DarkZachi83/NIUCHACZ-POST-Code-Sniffer-/docs/img/app.png

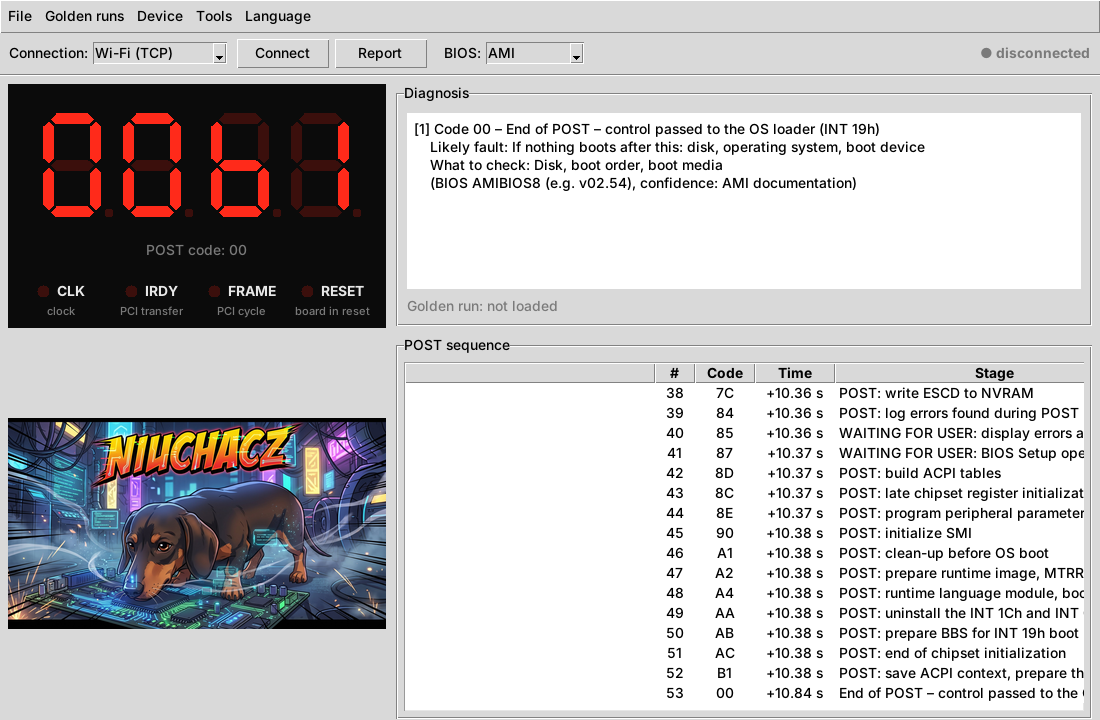
docs/img/app.png
