DarkZachi83/NIUCHACZ-POST-Code-Sniffer-/enclosure/niuchacz_box_podglad.png

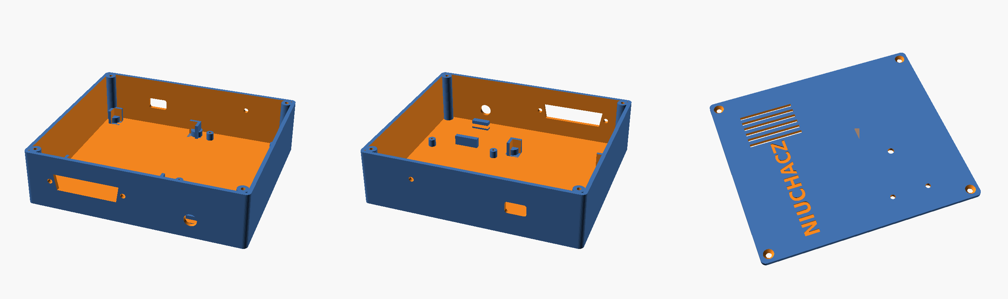
enclosure/niuchacz_box_podglad.png
