DarkZachi83/NIUCHACZ-POST-Code-Sniffer-/enclosure/niuchacz_box_v2_podglad.png

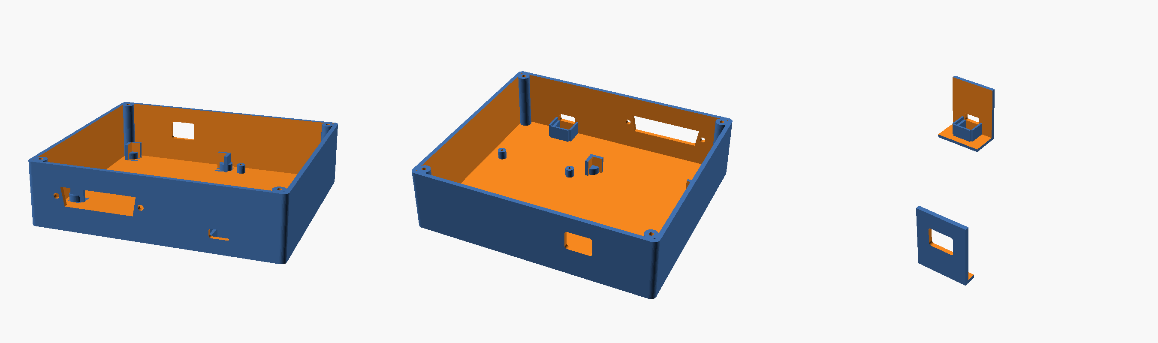
enclosure/niuchacz_box_v2_podglad.png
