DarkZachi83/NIUCHACZ-POST-Code-Sniffer-/enclosure/niuchacz_box_base.stl

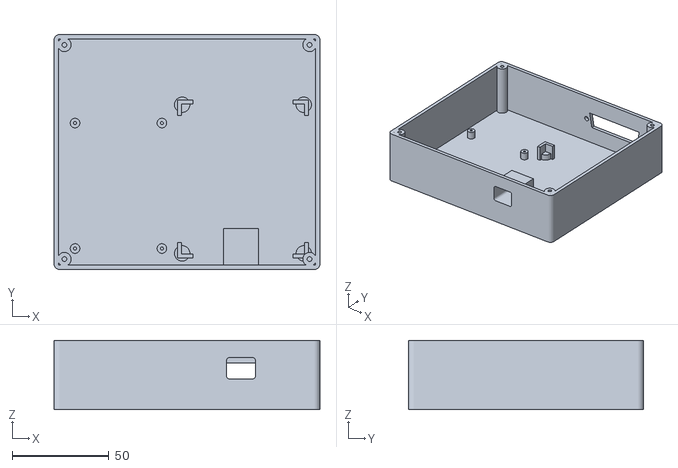
[picture p13: CAD file, 2026-10-23]
enclosure/niuchacz_box_base.stl
137.8 x 121.8 x 36.0
