DarkZachi83/NIUCHACZ-POST-Code-Sniffer-/enclosure/niuchacz_box_test.stl

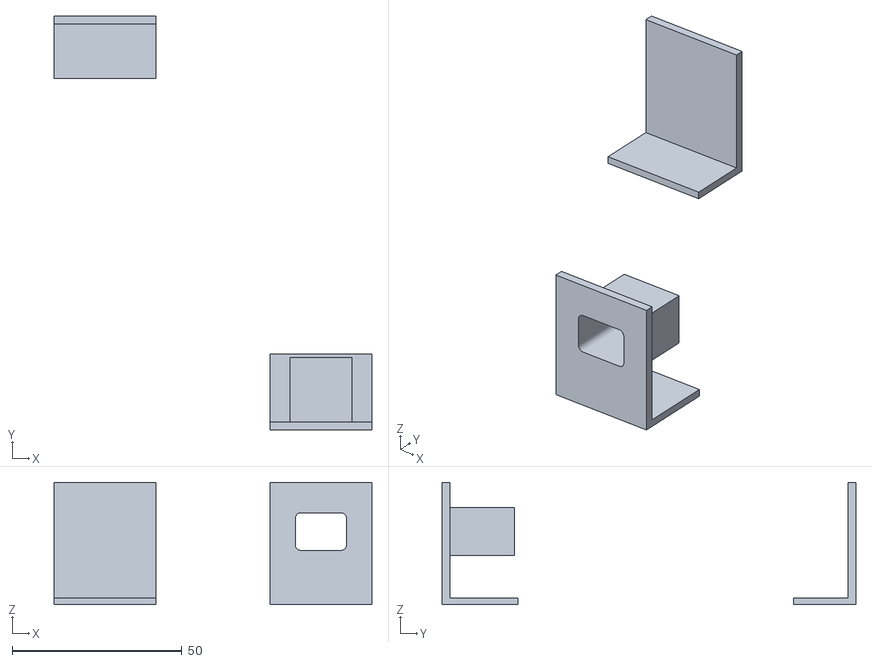
[picture p14: CAD file, 2026-10-23]
enclosure/niuchacz_box_test.stl
93.5 x 121.8 x 36.0
