DarkZachi83/NIUCHACZ-POST-Code-Sniffer-/enclosure/niuchacz_box_lid.stl

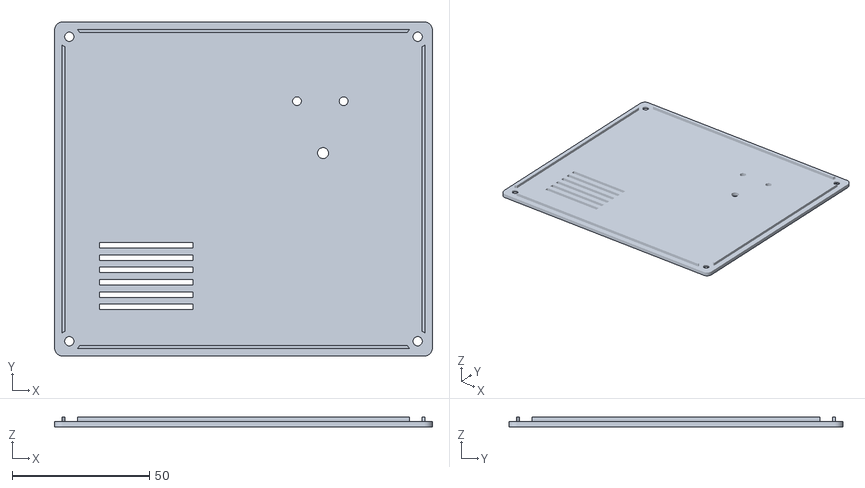
[picture p15: CAD file, 2026-10-23]
enclosure/niuchacz_box_lid.stl
137.8 x 121.8 x 3.60
