DarkZachi83/NIUCHACZ-POST-Code-Sniffer-/(list of files, cad)

Other CAD files:
enclosure/niuchacz_box_v1.scad
