DarkZachi83/NIUCHACZ-POST-Code-Sniffer-/docs/img/box_wiring.png

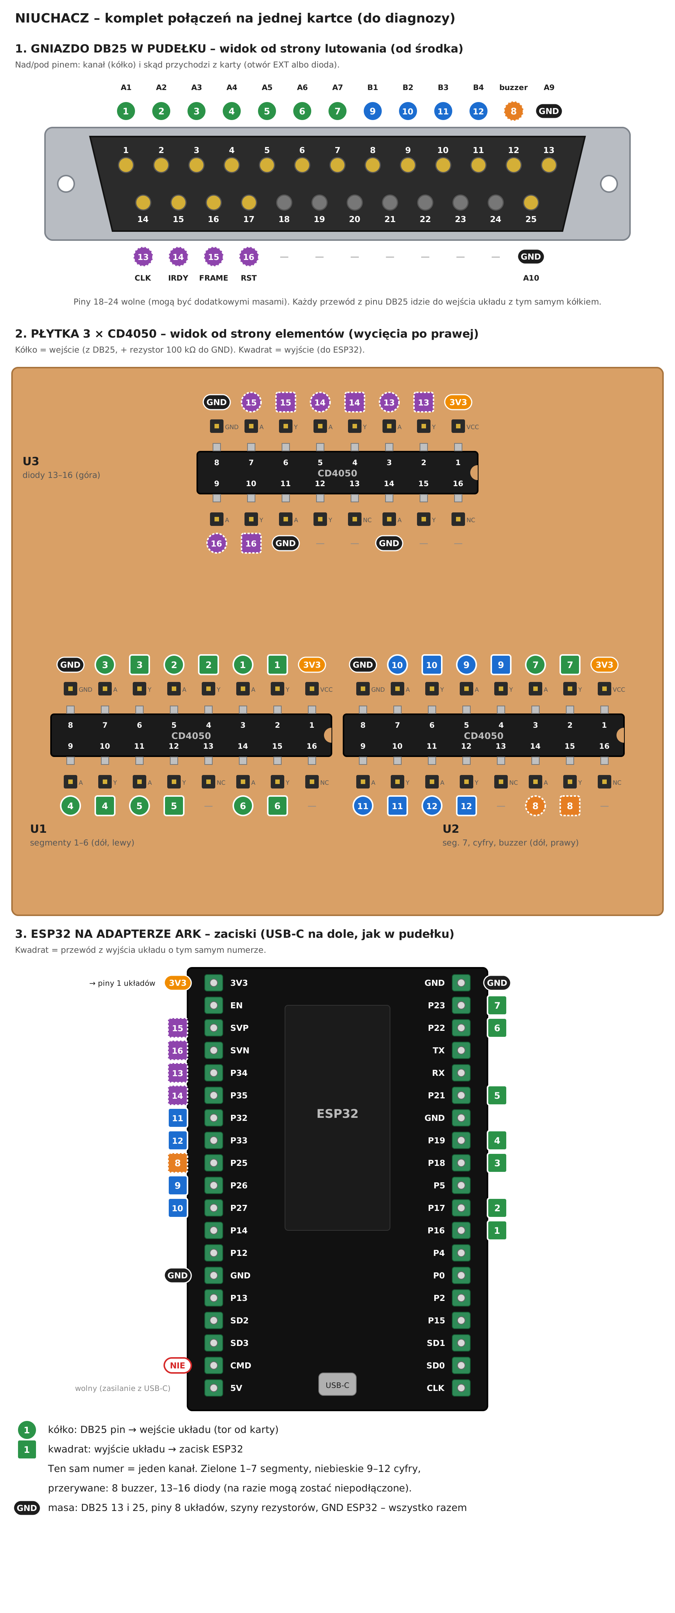
docs/img/box_wiring.png
