DarkZachi83/NIUCHACZ-POST-Code-Sniffer-/docs/img/card_374_wiring.png

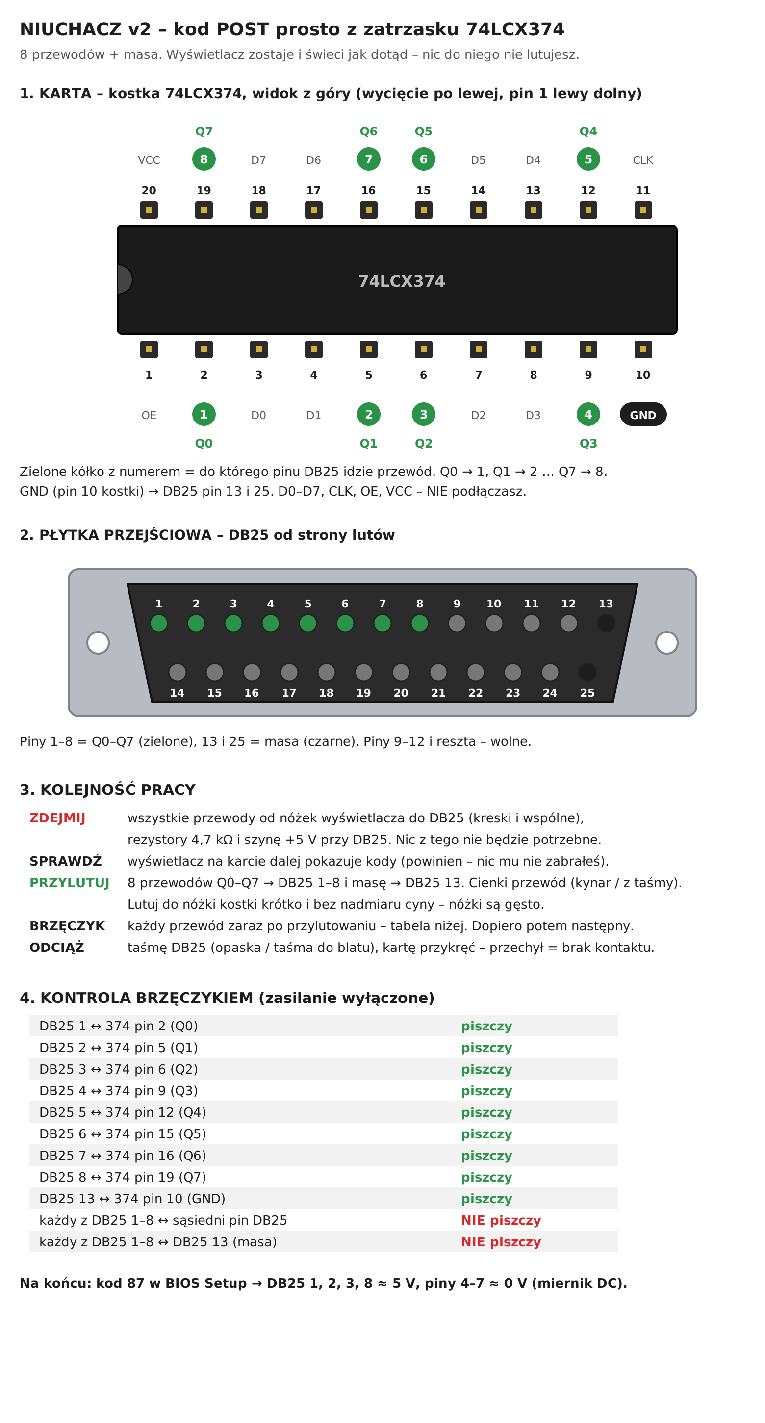
docs/img/card_374_wiring.png
