DarkZachi83/NIUCHACZ-POST-Code-Sniffer-/(commit log)

2026-10-23 NIUCHACZ 0.1 – pierwsza publiczna wersja / first public version
    Rejestrator kodów POST: ESP32 czyta zatrzask 74LCX374 karty POST PCI/ISA
    (Q0–Q7), aplikacja na PC zapisuje przebieg, opisuje kody AMIBIOS8 i tworzy raporty.
    POST code logger: an ESP32 reads the 74LCX374 latch of a PCI/ISA POST card,
    the desktop app records the run, describes AMIBIOS8 codes and builds reports.
    Claude-Session: https://claude.ai/code/session_01U3ZjCWiAyo7WSGjvTnHQTT
    [niuchacz_box.scad, niuchacz_box_base.stl, niuchacz_box_lid.stl, niuchacz_box_test.stl, niuchacz_box_v1.scad]
2026-10-23 README: odczyt z pinów układu 74LCX374 zamiast „zatrzasku” / reading the 74LCX374 pins
    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
2026-10-25 Narzędzie led_probe.py – szukanie sygnałów diod karty / tool for locating card LED signals
    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
2026-10-26 led_probe: pomiar ciągły bez przerw / continuous measurement
    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
2026-10-26 Firmware: diody karty w trybie zatrzasku, sesje z linii RESET / card LEDs and RESET-based sessions
    Pomiar 26.10.2026: IRDY i FRAME widoczne przy ruchu na szynie PCI, RESET = 0 w resecie,
    CLK 33 MHz za szybki dla toru CD4050 (zostaje bez odczytu).
    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
    [config.py, latch_probe.py, main.py, sampler.py]
2026-10-26 USB: bez błędu przy rozłączaniu (wątek najpierw kończy odczyt) / fix serial race on disconnect
    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
    [serial_transport.py]
2026-10-26 REC: record runs on demand, no automatic report popups
    - Live view always runs; nothing is saved or popped up by itself.
    - REC (F9) arms recording; it starts on RESET release (or boot-block code,
    or the first code when armed before power-on).
    - A reset during recording opens the next start in the same recording;
    after max starts (default 4) it ends with "restart loop" and the last
    code before each reset.
    - Ends on POST done (00/FF + 3 s), BIOS waiting (85/87, 5 s), stall or STOP.
    - Auto-saves TXT report + CSV to reports/, then asks "Record the next run?".
    - "Save last run" for runs that were not armed.
    - Report window only on request (Report / Ctrl+R) or if enabled in Settings.
    - EN/PL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
    [config.py, main.py]
2026-10-26 AMI: only D0 (reset vector) starts a new boot
    A real ASRock 775V88 recording showed DE right after code 90 (20 ms, no
    reset): the board runs D3 -> memory codes 10..90 -> DE, D4, D5... inside
    one boot. Treating any D* as a restart split one healthy boot into an
    extra "start" (and in older versions popped up an extra report).
    Other D* codes still count as a restart after a wait code or a stall,
    for the slow 7-segment mode where D0 can be missed.
    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
2026-10-26 Firmware: shorter blind gaps between latch windows, measure and flag them
    Three recordings of the same healthy ASRock 775V88 showed different code
    sets (e.g. 7C..AC missing but B1 present) - the latch keeps only the last
    byte, so codes written while the ESP32 is not sampling are lost.
    Firmware:
    - USB output is queued and sent ~1 line per gap (UART blocks ~3 ms/line,
    even with no PC attached); the rest is sent when the board is idle.
    - Flash flush and gc only when no new code for 1 s (were every 10 lines
    and every heartbeat, mid-burst).
    - LED state sent only on change (+2 s keepalive), not stored on flash.
    - Minimal latch window 15 -> 50 ms (fewer gaps).
    - Measures gaps: code messages ge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
    [main.py, protocol.py]
2026-10-26 REC: power-on noise (04 00 10 12 1A, then 00) is not "POST done"
    Right after power-on the latch shows random bytes and 00; the recording
    ended after 3 s as "POST finished". 00/FF now counts as the end of POST
    only after at least 10 codes in the start; otherwise the stall rule
    applies.
    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
2026-10-26 Firmware: no flash access while codes are coming in
    Recording with gap measurement (26.10.2026): longest gap 132 ms, and the
    "!" markers pointed exactly at lost codes (2E before 31!, 80/90 before
    DE!). LittleFS writes from store.append() and the new-session file
    create/prune on RESET hit the flash mid-burst (block erase = tens to
    hundreds of ms).
    - SessionStore keeps lines in RAM; open/write/prune only in flush(),
    which the main loop calls once the board sits on one code for 1 s
    (forced at 250 buffered lines).
    - gc.collect() once per idle period instead of every loop.
    Claude-Session: https://claude.ai/code/session_01U3ZjCWiAyo7WSG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
    [main.py, session_store.py]
2026-10-26 Firmware: write sessions to flash only after 10 s without a change
    "1 s without a change" is not idle: the board holds D1 for 1.1 s, 2A for
    4.9 s, 78 for 3.7 s and then bursts 30 codes in 20 ms. Flushing after 1 s
    produced a 1356 ms gap and lost D3..0C. Now: gc after 1 s (short), flash
    after 10 s, USB at most ~5 ms per gap at all times.
    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
    [main.py, session_store.py]
2026-10-26 Firmware: never force a flash write while the board is running
    A full RAM buffer (several quick runs without a 10 s pause) forced a
    write of ~300 lines with file switches and prunes: 3.4 s gap, D1 lost.
    Now the oldest buffered lines are dropped instead (the PC has them live),
    pruning runs once per flush, and gc runs after 300 ms of quiet so an
    automatic gc does not hit the middle of a burst.
    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
2026-10-26 Report defaults (owner, technician) and single-read short codes
    App:
    - Settings: "Filled in on every report" section with Owner, Technician
    and Board; used by every report, including REC auto-saved ones.
    - Codes caught in a single read are marked "~" in reports.
    Firmware (sampler):
    - C1/C4 appeared in some runs only and never with "!" - they last ~1 us
    (C2 C3 C4 C5 written back to back) and failed the 2-reads filter.
    A code seen once is now accepted (flagged) unless it is a bitwise mix
    of its neighbours (transition state) or a spike back to the same code.
    Python and viper versions checked against the same sequences.
    Claude-S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
    [config.py, main.py, protocol.py]
2026-10-26 Firmware: process captured codes a few per gap instead of all at once
    Each code costs ~3-5 ms in MicroPython (JSON, Wi-Fi write); after a burst
    of 10 codes the ESP32 was blind for ~46 ms, always at the same places
    (D3!, 61!, 13!). Codes now go to a queue and 3 are processed per gap;
    the queue is drained fully on RESET so codes never land after the next
    session marker.
    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
    [main.py]
2026-10-26 Firmware: on-device session storage off by default
    Every flash write stopped latch reading (measured 132 ms, 1356 ms,
    3437 ms, now 4569 ms right at D0 when a 10 s idle flush met a reset),
    and the RAM buffer makes MicroPython gc slower. The app records runs
    (REC), so the ESP32 no longer stores sessions unless
    STORE_SESSIONS = True in config.py.
    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
    [config.py, main.py, session_store.py]
2026-10-26 Firmware: name stale files at start instead of crashing later
    Files are copied to the ESP32 by hand; a leftover old sampler.py or
    protocol.py crashed in the sampling loop with AttributeError/TypeError.
    main.py now checks the modules at start and says which files to upload.
    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
    [main.py]
2026-10-26 Firmware: single-read flag must be a MicroPython small int (viper)
    0x40000000 is above the small-int range (max 0x3FFFFFFF), so viper treated
    it as an object: "ViperTypeError: can't do binary op between 'int' and
    'object'" on the ESP32. Flag is now 0x20000000; a test scans viper code
    for constants that are too large.
    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
    [main.py, sampler.py]
2026-10-26 Golden runs: a missing short code is not a divergence
    Same ASRock 775V88, two healthy runs: the reference had C1~ (a ~1 us code
    caught by a single read), the next run did not catch it and the comparison
    reported "divergence at position 34: expected C1, got C2".
    - compare() re-synchronises after missing or extra codes (lookahead 4,
    confirmed by the next code) and lists them instead of stopping.
    - References remember which codes were uncertain ("optional"); if only
    those are missing the message says it is normal for the reader.
    - A real divergence (other path, board stops) is still reported.
    - Old reference files load as before (unknown keys ignored).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
2026-10-26 enclosure: 3D-printed box (OpenSCAD source + STL, v3)
    Parametric OpenSCAD source, base/lid/test STL, preview and a PL/EN README
    with print settings, assembly and the parameters to adjust for other
    ESP32 boards.
    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
    [niuchacz_box.scad]
2026-10-26 enclosure: use the existing v3 preview, list history files
    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
2026-10-26 enclosure: v3 is the printed box in use
    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
2026-10-29 README: ask for a star and feedback; current screenshot (82 codes per boot)
    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
2026-11-02 Windows release: GitHub Actions builds NIUCHACZ.exe and publishes a ZIP
    - .github/workflows/windows-release.yml: on a v* tag, on windows-latest:
    run the tests, build with PyInstaller (no Python needed by the user),
    add config, code database, firmware, enclosure and docs, smoke-test
    that the exe starts, and publish the ZIP as a GitHub release.
    - main.py: when frozen, data lives next to NIUCHACZ.exe (writable).
    - docs/RELEASE_NOTES.md: how to install, SmartScreen note (EN + PL).
    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
